MengBowen-328p/Lightmeter/README.md

# CW32_Lightmeter

# Timeline

## 2023.9.2:Finished SCH
## 2023.9.4:Finished PCB Layout
