MengBowen-328p/Lightmeter/Hardware/CW32_Lightmeter-Edge_Cuts.dxf

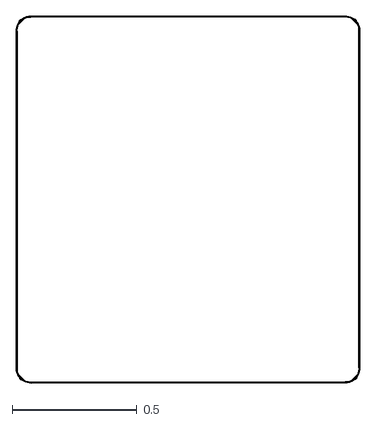
[picture p1: CAD file, 2023-10-05]
Hardware/CW32_Lightmeter-Edge_Cuts.dxf
1.38 x 1.47
