MengBowen-328p/Lightmeter/Hardware/CW32_Lightmeter-B_Cu.dxf

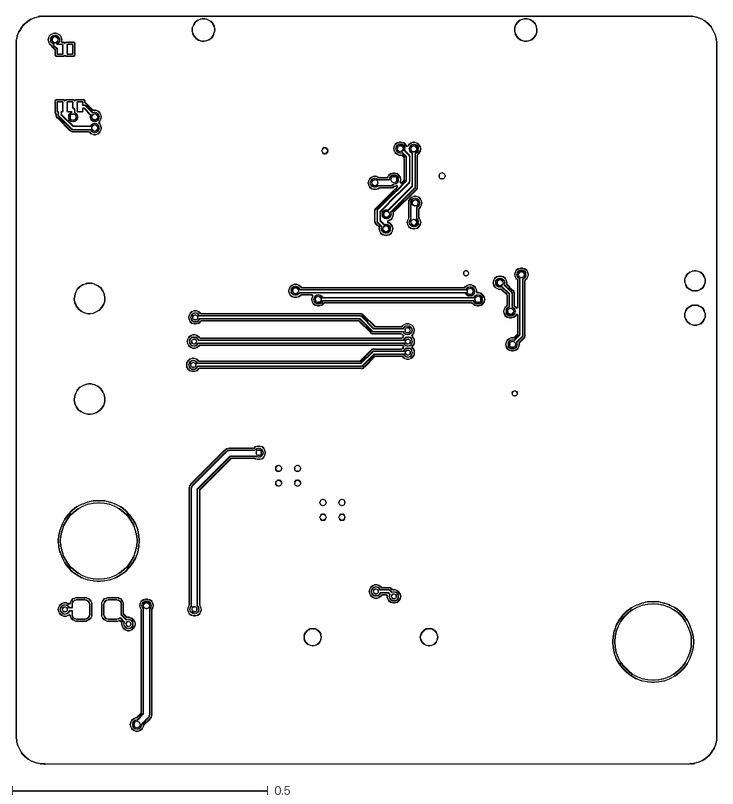
[picture p3: CAD file, 2023-10-05]
Hardware/CW32_Lightmeter-B_Cu.dxf
1.37 x 1.46
