MengBowen-328p/Lightmeter/(list of files, cad)

Other CAD files:
Hardware/CW32_Lightmeter-B_Mask.dxf
Hardware/CW32_Lightmeter-B_Paste.dxf
Hardware/CW32_Lightmeter-B_Silkscreen.dxf
Hardware/CW32_Lightmeter-F_Mask.dxf
Hardware/CW32_Lightmeter-F_Paste.dxf
Hardware/CW32_Lightmeter-F_Silkscreen.dxf
