MengBowen-328p/Lightmeter/Hardware/CW32_Lightmeter.kicad_pcb

## KiCad design Hardware/CW32_Lightmeter.kicad_pcb (2023-10-08)

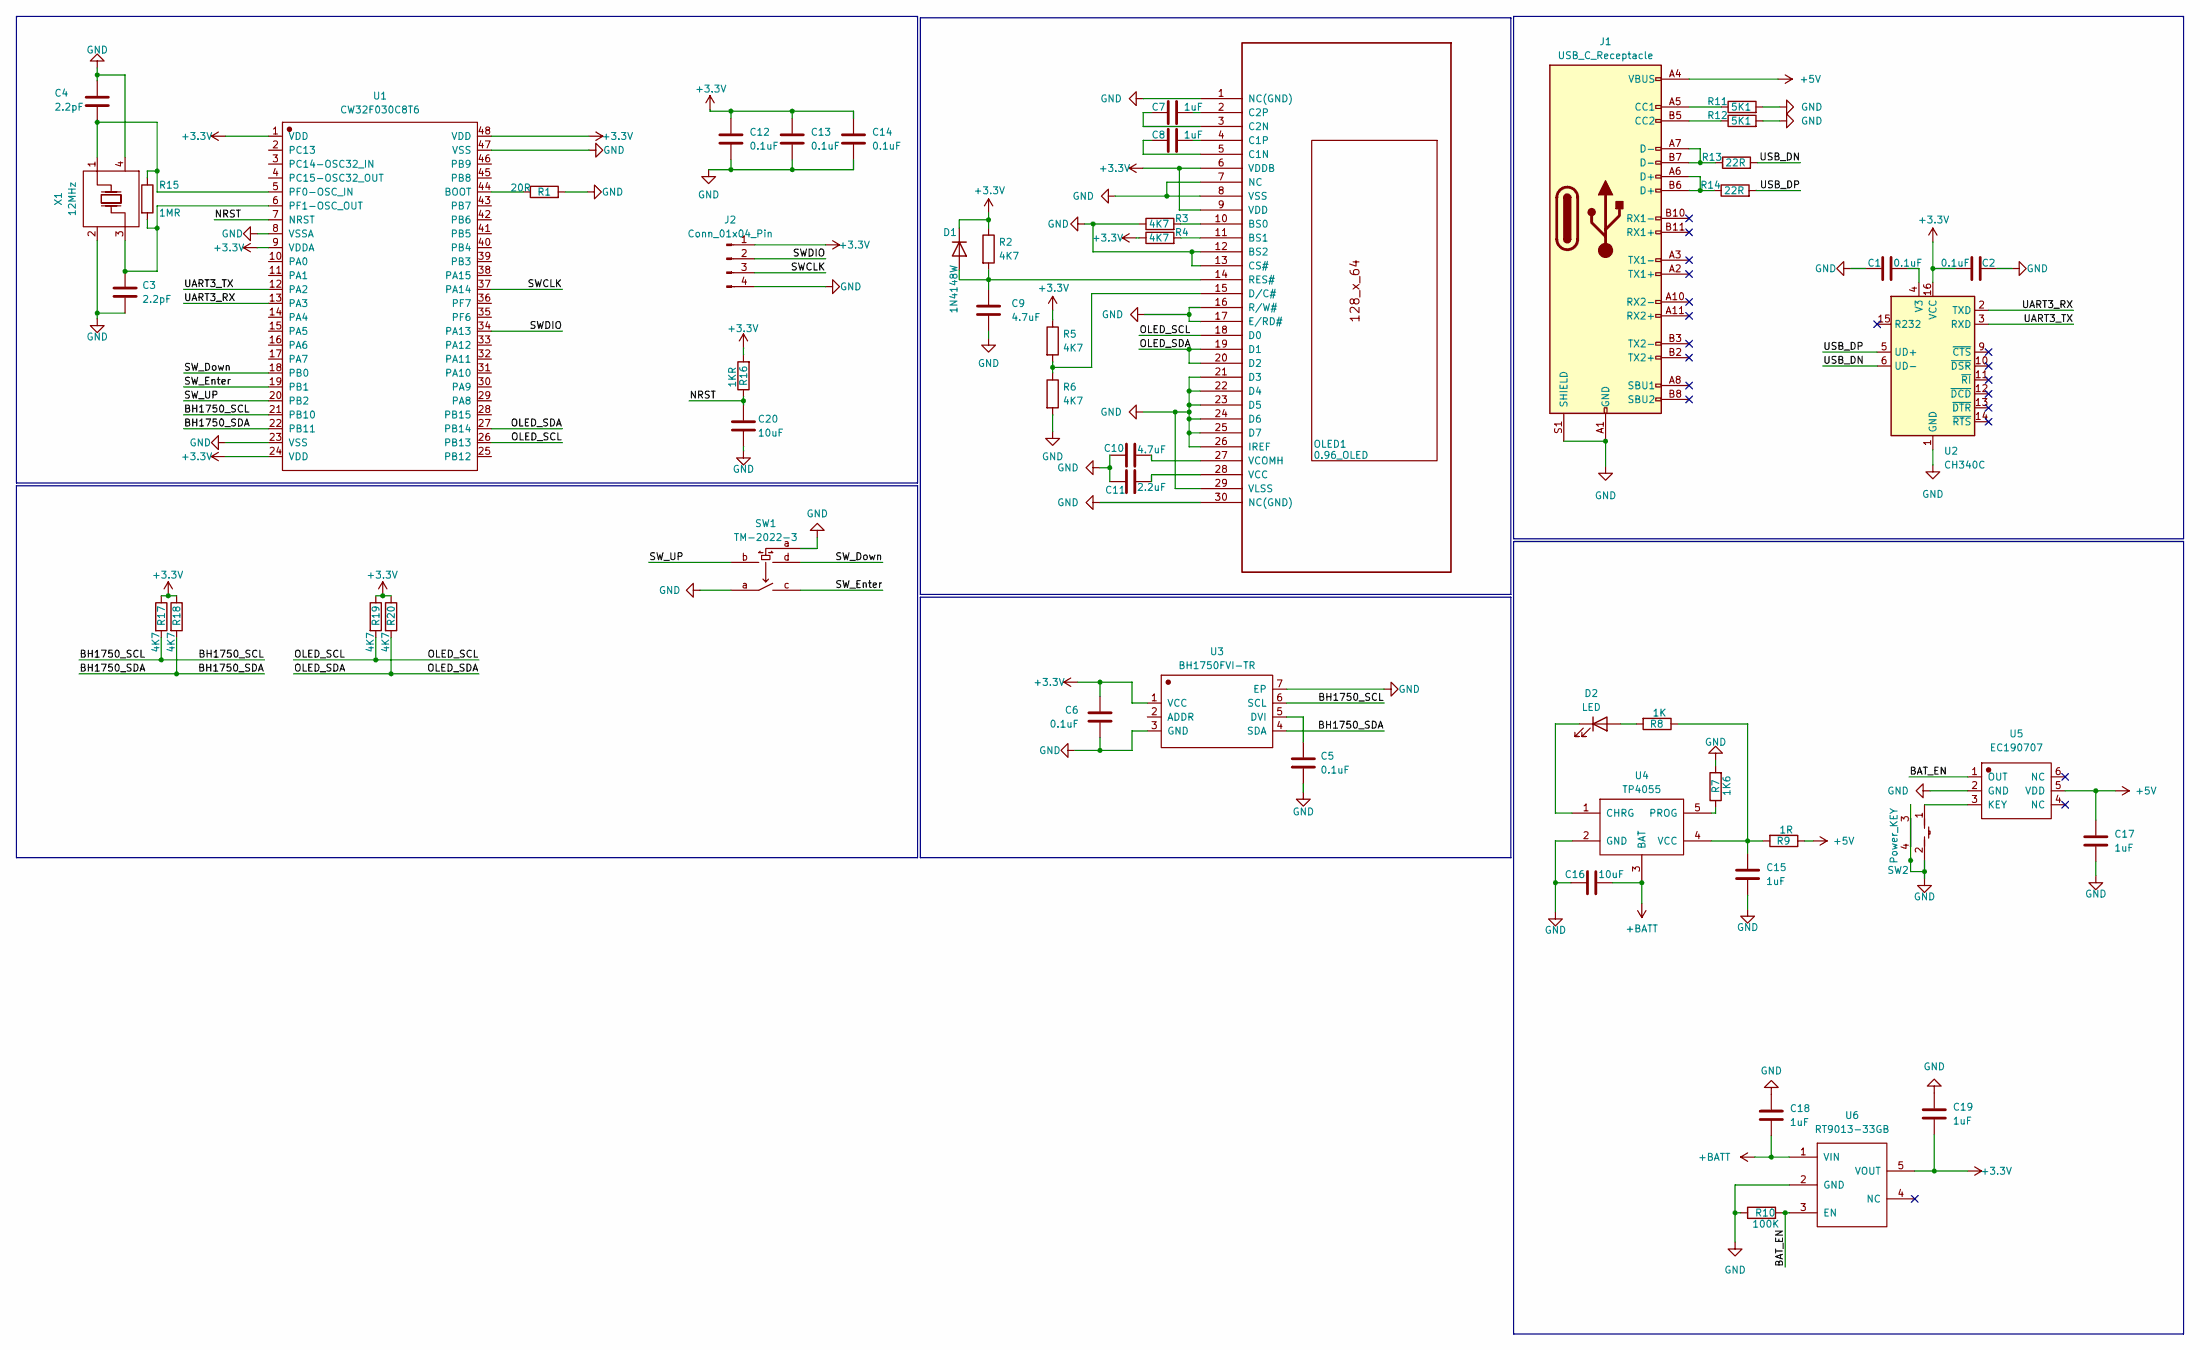
[picture p4: schematic CW32_Lightmeter.kicad_sch]

Parts:
C1, C2, C5, C6, C12, C13, C14: 0.1uF; C_0603_1608Metric
C3, C4: 2.2pF; C_0603_1608Metric
C7, C8, C15, C17, C18, C19: 1uF; C_0603_1608Metric
C9, C10: 4.7uF; C_0603_1608Metric
C11: 2.2uF; C_0603_1608Metric
C16, C20: 10uF; C_0603_1608Metric
D1: 1N4148W; D_SOD-123
D2: LED; LED_0603_1608Metric
J1: USB_C_Receptacle; USB_C_Receptacle_GCT_USB4105-xx-A_16P_TopMnt_Horizontal
J2: Conn_01x04_Pin; SWD_Port
OLED1: 0.96_OLED; OLED_0.96-30P-P0.70-12864
R1: 20R; R_0603_1608Metric
R2, R3, R4, R5, R6, R17, R18, R19, R20: 4K7; R_0603_1608Metric
R7: 1K6; R_0603_1608Metric
R8: 1K; R_0603_1608Metric
R9: 1R; R_0603_1608Metric
R10: 100K; R_0603_1608Metric
R11, R12: 5K1; R_0603_1608Metric
R13, R14: 22R; R_0603_1608Metric
R15: 1MR; R_0603_1608Metric
R16: 1KR; R_0603_1608Metric
SW1: TM-2022-3; SW-SMD_TM-2022-3
SW2: Power_KEY; SW-SMD_2X4X3.5MM
U1: CW32F030C8T6; LQFP-48_L7.0-W7.0-P0.50-LS9.0-BL
U2: CH340C; SOIC-16_3.9x9.9mm_P1.27mm
U3: BH1750FVI-TR; WSOF-6_L2.6-W1.6-P0.50-TL-EP
U4: TP4055; SOT-23-5_L3.0-W1.7-P0.95-LS2.8-BR
U5: EC190707; PG-SOT23-6_L2.9-W1.6-P0.95-LS2.8-BR
U6: RT9013-33GB; SOT-23-5_L3.0-W1.7-P0.95-LS2.8-BL
X1: 12MHz; CRYSTAL-SMD_4P-L3.2-W2.5-BL

Connections:
+3.3V: C2.2, C6.2, C12.1, C13.1, C14.1, C19.2, D1.1 (K), J2.1, OLED1.6 (VDDB), OLED1.9 (VDD), R2.1, R4.1, R5.1, R16.2, R17.1, R18.1, R19.1, R20.1, U1.1 (VDD), U1.9 (VDDA), U1.24 (VDD), U1.48 (VDD), U2.16 (VCC), U3.1 (VCC), U6.5 (VOUT)
+5V: C17.1, J1.A4 (VBUS), J1.A9 (VBUS), J1.B4 (VBUS), J1.B9 (VBUS), R9.1, U5.5 (VDD)
+BATT: C16.2, C18.2, U4.3 (BAT), U6.1 (VIN)
/BAT_EN: R10.2, U5.1 (OUT), U6.3 (EN)
/BH1750_SCL: R17.2, U1.21 (PB10), U3.6 (SCL)
/BH1750_SDA: R18.2, U1.22 (PB11), U3.4 (SDA)
/NRST: C20.1, R16.1, U1.7 (NRST)
/OLED_SCL: OLED1.18 (D0), R19.2, U1.26 (PB13)
/OLED_SDA: OLED1.19 (D1), OLED1.20 (D2), R20.2, U1.27 (PB14)
/SWCLK: J2.3, U1.37 (PA14)
/SWDIO: J2.2, U1.34 (PA13)
/SW_Down: SW1.d, U1.18 (PB0)
/SW_Enter: SW1.c, U1.19 (PB1)
/SW_UP: SW1.b, U1.20 (PB2)
/UART3_RX: U1.13 (PA3), U2.2 (TXD)
/UART3_TX: U1.12 (PA2), U2.3 (RXD)
/USB_DN: R13.2, U2.6 (UD-)
/USB_DP: R14.2, U2.5 (UD+)
GND: C1.1, C2.1, C3.2, C4.1, C5.2, C6.1, C9.2, C10.1, C11.1, C12.2, C13.2, C14.2, C15.2, C16.1, C17.2, C18.1, C19.1, C20.2, J1.A1 (GND), J1.A12 (GND), J1.B1 (GND), J1.B12 (GND), J1.S1 (SHIELD), J2.4, OLED1.1 (NC(GND)), OLED1.7 (NC), OLED1.8 (VSS), OLED1.12 (BS2), OLED1.13 (CS#), OLED1.16 (R/W#), OLED1.17 (E/RD#), OLED1.21 (D3), OLED1.22 (D4), OLED1.23 (D5), OLED1.24 (D6), OLED1.25 (D7), OLED1.26 (IREF), OLED1.29 (VLSS), OLED1.30 (NC(GND)), R1.2, R3.1, R6.2, R7.2, R10.1, R11.2, R12.2, SW1.a, SW2.2, SW2.3, SW2.4, U1.8 (VSSA), U1.23 (VSS), U1.47 (VSS), U2.1 (GND), U3.3 (GND), U3.7 (EP), U4.2 (GND), U5.2 (GND), U6.2 (GND), X1.2 (GND), X1.4 (GND)
unnamed: C9.1, D1.2 (A), OLED1.14 (RES#), R2.2
unnamed: D2.2 (A), R8.2
unnamed: D2.1 (K), U4.1 (CHRG)
unnamed: J1.A5 (CC1), R11.1
unnamed: J1.B5 (CC2), R12.1
unnamed: J1.A6 (D+), J1.B6 (D+), R14.1
unnamed: J1.A7 (D-), J1.B7 (D-), R13.1
unnamed: OLED1.10 (BS0), R3.2
unnamed: OLED1.11 (BS1), R4.2
unnamed: C8.1, OLED1.5 (C1N)
unnamed: C8.2, OLED1.4 (C1P)
unnamed: C7.1, OLED1.3 (C2N)
unnamed: C7.2, OLED1.2 (C2P)
unnamed: OLED1.15 (D/C#), R5.2, R6.1
unnamed: C11.2, OLED1.28 (VCC)
unnamed: C10.2, OLED1.27 (VCOMH)
unnamed: R1.1, U1.44 (BOOT)
unnamed: C4.2, R15.1, U1.5 (PF0-OSC_IN), X1.1 (OSC1)
unnamed: C3.1, R15.2, U1.6 (PF1-OSC_OUT), X1.3 (OSC2)
unnamed: C1.2, U2.4 (V3)
unnamed: C5.1, U3.5 (DVI)
unnamed: R7.1, U4.5 (PROG)
unnamed: C15.1, R8.1, R9.2, U4.4 (VCC)
unnamed: SW2.1, U5.3 (KEY)

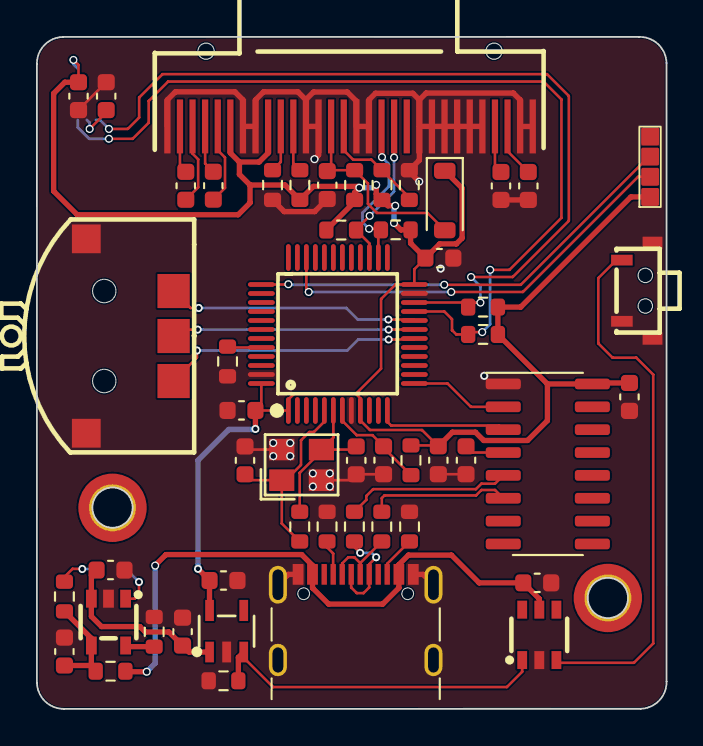
[picture p5: board CW32_Lightmeter.kicad_pcb from above]

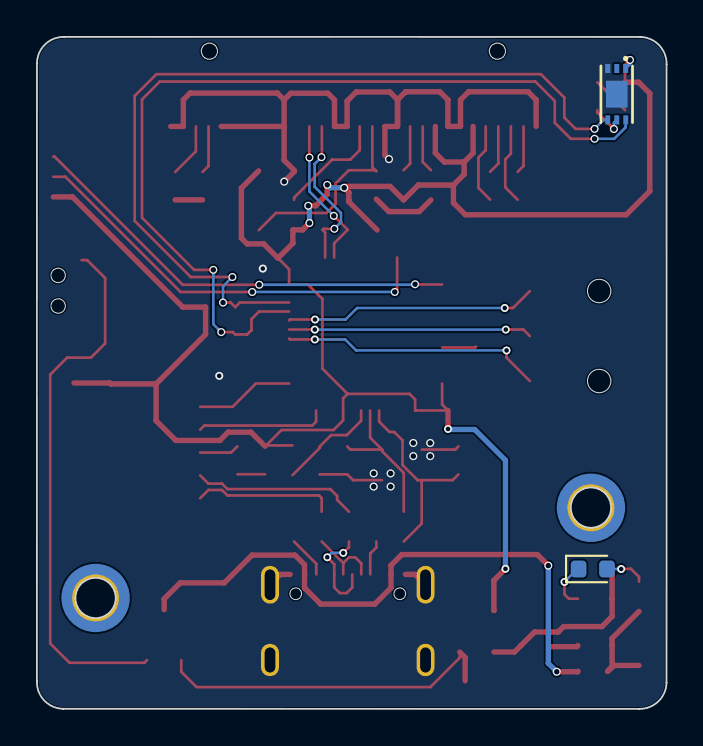
[picture p6: board CW32_Lightmeter.kicad_pcb from below]

Board: 2 copper layers, 35.0 x 37.3 mm, 54 parts (2 on the bottom side), 43 nets.
