MengBowen-328p/Lightmeter/(commit log)

2023-09-02 Update SCH
    [CW32_Lightmeter.kicad_pcb, CW32_Lightmeter.kicad_sch]
2023-09-03 Update PCB Layout
    [CW32_Lightmeter.kicad_pcb, CW32_Lightmeter.kicad_sch]
2023-09-04 Finished PCB Layout
    [CW32_Lightmeter.kicad_pcb, CW32_Lightmeter.kicad_sch]
2023-09-05 Hardware Finished
    [CW32_Lightmeter.kicad_pcb]
2023-09-12 Finsished PCB Layout
    [CW32_Lightmeter-B_Cu.dxf, CW32_Lightmeter-B_Mask.dxf, CW32_Lightmeter-B_Paste.dxf, CW32_Lightmeter-B_Silkscreen.dxf, CW32_Lightmeter-Edge_Cuts.dxf, CW32_Lightmeter-F_Cu.dxf, CW32_Lightmeter-F_Mask.dxf, CW32_Lightmeter-F_Paste.dxf]
2023-10-05 Update Switch Driver
    [CW32_Lightmeter.kicad_pcb]
2023-10-08 Update I2C
    [CW32_Lightmeter-B_Cu.dxf, CW32_Lightmeter-B_Mask.dxf, CW32_Lightmeter-B_Paste.dxf, CW32_Lightmeter-B_Silkscreen.dxf, CW32_Lightmeter-Edge_Cuts.dxf, CW32_Lightmeter-F_Cu.dxf, CW32_Lightmeter-F_Mask.dxf, CW32_Lightmeter-F_Paste.dxf]
2023-11-16 Refactor By Arduino
2023-11-19 Update Button
